Qcwerty123/vuon-uom-iot/hardware/nhat-ky-lap-dat.md

# Nhật ký lắp đặt

Điền trong lúc lắp (nguồn: `docs/huong-dan-lap-dat-phan-cung.md` Phụ lục 2). Firmware Node 1 cần các số hiệu chuẩn ở đây.

| Mục | Giá trị | Ngày |
|---|---|---|
| Điện áp ra củ sạc 5V/3A | ___ V | |
| Điện áp ra củ sạc 5V/2A | ___ V | |
| Chip USB của ESP32 (CP210x / CH340) | | |
| Jumper hàng V của đế | 3V3 / 5V | |
| Địa chỉ I2C của OLED (SH1106) | 0x__ | |
| Địa chỉ BH1750 | 0x__ | |
| Cảm biến đất (loại điện trở) cấp qua GPIO32: đèn module sáng rõ khi đo? | Có / Không | |
| Đất 1: DRY / WET | ____ / ____ | |
| Đất 2: DRY / WET | ____ / ____ | |
| Thứ tự chân keypad P1…P7 | | |
| Chế độ kích relay | H / L | |
| Điện áp cầu chia ECHO | ___ V | |
| HC-SR04 tại 20 cm thước | ___ cm | |
| `TANK_EMPTY_CM` / `TANK_FULL_CM` | ___ / ___ | |
| Lưu lượng bơm | ___ ml / 10 s | |
| Điện áp +5 V khi bơm + quạt + đèn cùng chạy | ___ V | |
| Đèn: công suất ghi trên nhãn | ___ W | |
| ΔE_LED (`lamp_self_lux`) = lux đèn bật − lux đèn tắt, phòng tối | ___ lux | |
| Quạt dùng | Quạt 5 V / động cơ mini gắn cánh | |
| Node 2: độ phân giải ổn định | SVGA / VGA | |
| Node 2: có brownout không | Có / Không | |

Kèm ảnh từng công đoạn (📸) và video bơm chạy theo lệnh. Đây là bằng chứng "hình ảnh sản phẩm thực tế" mà đề bài yêu cầu trong báo cáo.
