Qcwerty123/vuon-uom-iot/docs/diagrams/README.md

# Sơ đồ thiết kế

Đề bài (mục 6) yêu cầu tối thiểu 14 mô hình. Lưu mỗi sơ đồ ở 2 dạng: **file nguồn** để sửa (`.drawio`, `.mmd`, `.puml`) và **ảnh xuất** (`.png` hoặc `.svg`) để chèn báo cáo.

Công cụ gợi ý: draw.io (diagrams.net), Mermaid, PlantUML. Nhiều sơ đồ đã có sẵn bản Mermaid trong `../dac-ta-he-thong.md`, có thể xuất thẳng.

| # | Mô hình | Tên file gợi ý | Nguồn nội dung | Trạng thái |
|---|---|---|---|---|
| 1 | Sơ đồ bối cảnh hệ thống | `01-boi-canh` | Đặc tả §3.1 | ⬜ |
| 2 | Use case | `02-use-case` | Đặc tả §3.2, slide 4 | ⬜ |
| 3 | Kiến trúc tổng thể | `03-kien-truc` | Đặc tả §4.1 (Mermaid) | ⬜ |
| 4 | Sơ đồ các lớp (thiết bị, kết nối, edge, backend, dữ liệu, ứng dụng) | `04-cac-lop` | Đặc tả §4.1 | ⬜ |
| 5 | Sơ đồ khối phần cứng | `05-khoi-phan-cung` | Đặc tả §5.5, slide 6 | ⬜ |
| 6 | Sơ đồ nối cảm biến và cơ cấu chấp hành | `06-noi-day` (Fritzing hoặc Wokwi) | Đặc tả §5.2, §5.3; hướng dẫn lắp đặt §B3 | ⬜ |
| 7 | Sơ đồ triển khai | `07-trien-khai` | Đặc tả §17.1 | ⬜ |
| 8 | ERD | `08-erd` | Đặc tả §11.1 (Mermaid), `database/init/01_schema.sql` | ⬜ |
| 9 | Mô tả API | `09-api` (xuất OpenAPI từ code) | Đặc tả §10 | ⬜ |
| 10 | Topic và payload MQTT | `10-mqtt` | Đặc tả §8 | ⬜ |
| 11 | Sequence ≥ 2 | `11a-gui-lenh`, `11b-cap-phat`, `11c-chup-chan-doan`, `11d-offline` | Đặc tả §3.3, §9.1, slide 7 | ⬜ |
| 12 | Trạng thái vòng đời thiết bị | `12-vong-doi` | Đặc tả §12.1 (Mermaid) | ⬜ |
| 13 | Ma trận vai trò và quyền | `13-ma-tran-quyen` | Đặc tả §14.1 | ⬜ |
| 14 | Mô hình mối đe dọa | `14-moi-de-doa` | Đặc tả §14.4 | ⬜ |
