Qcwerty123/vuon-uom-iot/docs/slides/README.md

# Slide thuyết trình

Bộ slide 13 trang được soạn trên claude.ai:

https://claude.ai/artifact/4BR1WVpxi1zqWRhUVcc4Gz

- Trang đang ở chế độ riêng tư. Chủ sở hữu vào menu **Share** để chia sẻ cho các thành viên.
- Xuất bản nộp: trong trang slide chọn **Export** → PDF hoặc PowerPoint, lưu vào thư mục này với tên `slide-thuyet-trinh.pdf` / `.pptx`.
- Trước khi xuất: điền tên, mã sinh viên, link GitHub (slide 1), ảnh và số liệu thật (các ô `[__]`).
