Qcwerty123/vuon-uom-iot/hardware/bom.md

# Danh sách linh kiện (BOM)

Điền cột đơn giá sau khi đối chiếu hóa đơn. Tổng chi phí đưa vào báo cáo và slide.

| # | Linh kiện | SL | Đơn giá (đ) | Dùng cho |
|---|---|---|---|---|
| 1 | ESP32-WROOM-32 NodeMCU-32S 30 chân | 1 | | Node 1 |
| 2 | Đế ra chân ESP32 30 chân | 1 | | Node 1 |
| 3 | ESP32-CAM OV2640 + đế nạp MB | 1 | | Node 2 |
| 4 | Cảm biến độ ẩm đất (loại điện trở) | 2 | | Node 1 |
| 5 | DHT22 | 1 | | Node 1 |
| 6 | DHT11 | 1 | | Dự phòng (không gắn Node 2) |
| 7 | BH1750 (GY-302) | 1 | | Node 1 |
| 8 | HC-SR04 | 1 | | Node 1 — mực nước bể |
| 9 | OLED 1.3" I2C (SH1106) | 1 | | Node 1 |
| 10 | Keypad 3×4 mềm | 1 | | Node 1 |
| 11 | Relay 4 kênh 5 V (chọn mức H/L) | 1 | | Node 1 |
| 12 | Bơm chìm mini 3–6 V | 1 | | Tưới |
| 13 | Ống dẫn nước φ6, 97 cm | 1 | | Tưới |
| 14 | Quạt 5 V | 1 | | Thông gió |
| 15 | Động cơ mini 3–6 V | 1 | | Dự phòng, hoặc chế thành quạt thay quạt 5 V (C3) |
| 16 | Tụ hóa 1000 µF 16 V (túi 20) | 1 | | Lọc nguồn |
| 17 | Diode 1N4007 (túi 10) | 1 | | Chống xung ngược |
| 18 | Điện trở 1 kΩ, 2 kΩ (dây 50) | 2 | | Cầu chia áp ECHO |
| 19 | Domino 12 cực | 1 | | Thanh nguồn 5 V / GND |
| 20 | Breadboard 400 lỗ | 1 | | Bus I2C, cầu chia |
| 21 | Dây cái-cái, đực-cái 40P; dây đồng 0,6 mm; header 1×40 | — | | Đấu nối |
| 22 | Củ sạc 5V/3A, 5V/2A | 2 | | Nguồn Node 1, Node 2 |
| | **Cần mua thêm** | | | |
| 23 | Module USB ra chân có in cực (hoặc jack DC có cọc vít) | 1 | | Nguồn vào domino |
| 24 | Đồng hồ vạn năng cơ bản (DT-830) | 1 | | Đo kiểm khi lắp |
| 25 | Bể nước, khay, đất, cây giống cà chua | — | | Mô hình |
| 26 | Cánh quạt nhựa vừa trục động cơ mini + giá kẹp | 1 | | Chỉ khi chế quạt từ động cơ mini |
| 27 | Đèn LED 5 V ánh trắng ≤ 5 W | 1 | | Chiếu sáng bổ sung — relay kênh 3 (§6.11) |
| | **Tổng** | | | |
