Qcwerty123/vuon-uom-iot/tests/api/README.md

# Kiểm thử API

Backend dùng FastAPI (đặc tả C1): kiểm thử bằng pytest + httpx, đặt ở đây hoặc trong `backend/api/tests`.

Tối thiểu bao phủ FT1, FT2, FT5, FT8, ST1, ST2, ST5 trong `../scenarios.md`.
