Qcwerty123/vuon-uom-iot/firmware/test-hardware/secrets.example.h

// Sao chép file này thành tab "secrets.h" trong Arduino IDE rồi điền giá trị thật.
// secrets.h đã nằm trong .gitignore — KHÔNG commit.
#pragma once

#define WIFI_SSID "ten-wifi-2.4GHz"
#define WIFI_PASS "mat-khau-wifi"
