Qcwerty123/vuon-uom-iot/(commit log)

2026-11-06 feat: deploy fastapi (auth, device, ingest mqtt, websocket)
2026-11-07 docs(frontend): hướng dẫn cài dependency
2026-11-09 git commit -m "feat(firmware,docs): thêm firmware Node 2 và cập nhật đèn chiếu sáng Node 1 v1.1.0"
2026-11-09 docs: cập nhạt docs
2026-11-09 feat(wp07): AI service, nhận ảnh Node 2, DiagnosisWorker, API chẩn đoán (WIP)
2026-11-09 feat(wp07): camera giả, smoke_wp07, test-backend -Wp 07, README AI, MOCK.diagnoses=false
2026-11-09 docs(wp07): ghi chú lamp_on và lệch cấu hình camera sau khi đồng bộ dev
2026-11-10 feat(wp08): node 1: light, configure camera
